leptun/AVRinator/Hardware/AVRinator.kicad_pcb

## KiCad design Hardware/AVRinator.kicad_pcb (2024-05-07)

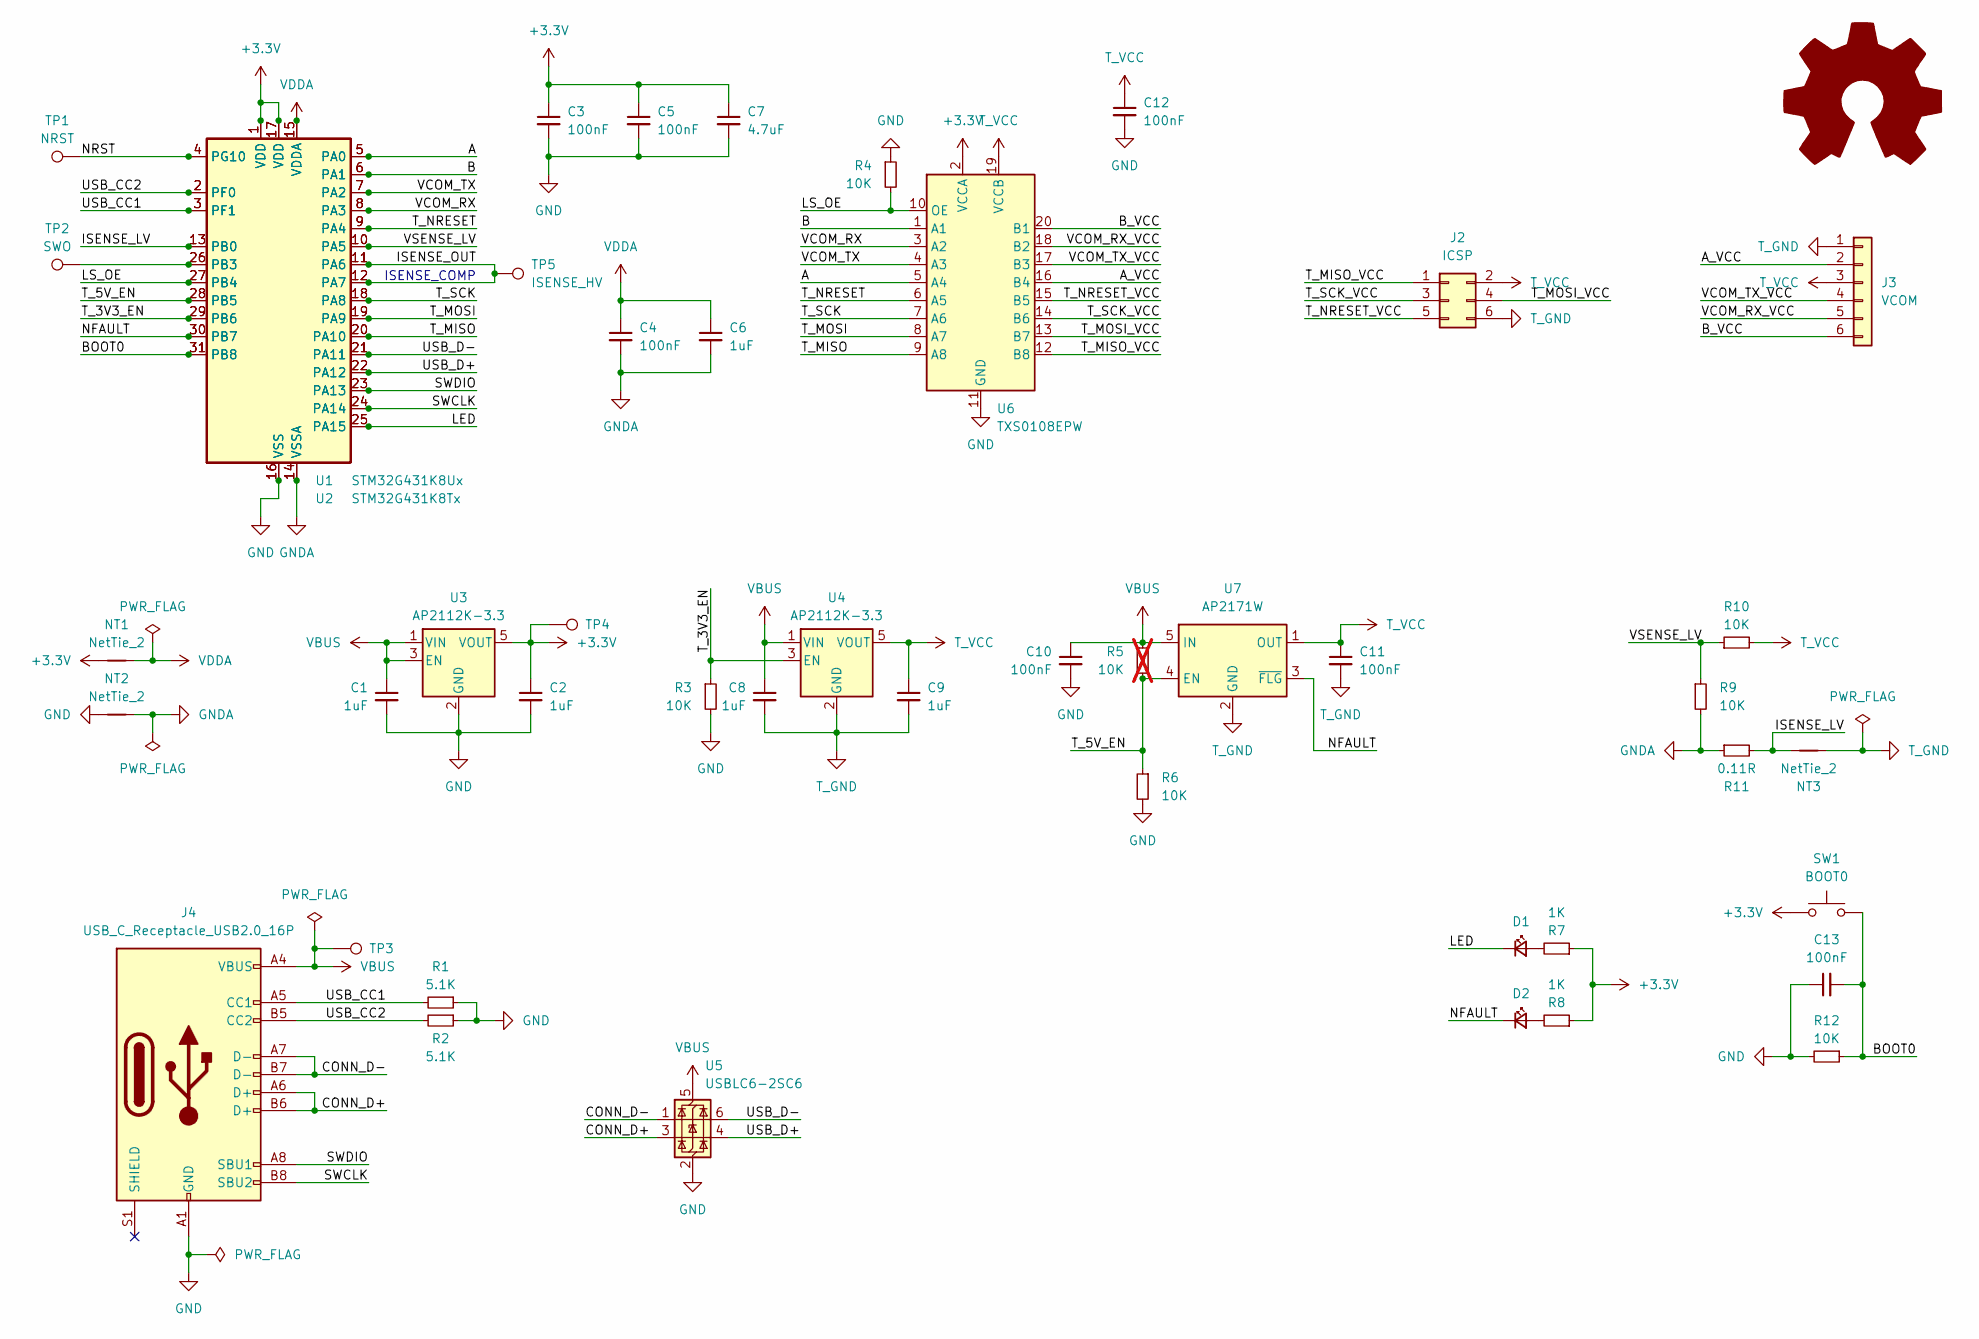
[picture p1: schematic AVRinator.kicad_sch]

Parts:
C1, C2, C6, C8, C9: 1uF; C_0805_2012Metric
C3, C4, C5, C10, C11, C12, C13: 100nF; C_0603_1608Metric
C7: 4.7uF; C_1206_3216Metric
D1, D2: LED_1206_3216Metric
J2: ICSP; 61200621621
J3: VCOM; PinSocket_1x06_P2.54mm_Horizontal
J4: USB_C_Receptacle_USB2.0_16P; USB4110-GF-A
NT1, NT2, NT3: NetTie_2; NetTie-2_SMD_Pad0.5mm
R1, R2: 5.1K; R_0603_1608Metric
R3, R4, R6, R9, R10, R12: 10K; R_0603_1608Metric
R5: 10K; R_0603_1608Metric; not fitted
R7, R8: 1K; R_0805_2012Metric
R11: 0.11R; R_0805_2012Metric
SW1: BOOT0; SW_Tactile_SPST_NO_Straight_CK_PTS636Sx25SMTRLFS
SYM1: AMOGUS; AMOGUS_lil
TP1: NRST; TestPoint_Pad_D1.0mm
TP2: SWO; TestPoint_Pad_D1.0mm
TP3: VBUS; TestPoint_Pad_D1.0mm
TP4: 3V3; TestPoint_Pad_D1.0mm
TP5: ISENSE_HV; TestPoint_Pad_D1.0mm
U1: STM32G431K8Ux; QFN-32-1EP_5x5mm_P0.5mm_EP3.45x3.45mm
U2: STM32G431K8Tx; LQFP-32_7x7mm_P0.8mm
U3, U4: AP2112K-3.3; SOT-23-5
U5: USBLC6-2SC6; SOT-23-6
U6: TXS0108EPW; TSSOP-20_4.4x6.5mm_P0.65mm
U7: AP2171W; SOT-23-5

Connections:
+3.3V: C2.1, C3.1, C5.1, C7.1, NT1.1, R7.1, R8.1, SW1.1, TP4.1, U1.1 (VDD), U1.17 (VDD), U2.1 (VDD), U2.17 (VDD), U3.5 (VOUT), U6.2 (VCCA)
/A: U1.5 (PA0), U2.5 (PA0), U6.5 (A4)
/A_VCC: J3.2, U6.16 (B4)
/B: U1.6 (PA1), U2.6 (PA1), U6.1 (A1)
/BOOT0: C13.2, R12.1, SW1.2, U1.31 (PB8), U2.31 (PB8)
/B_VCC: J3.6, U6.20 (B1)
/CONN_D+: J4.A6 (D+), J4.B6 (D+), U5.3 (I/O2)
/CONN_D-: J4.A7 (D-), J4.B7 (D-), U5.1 (I/O1)
/ISENSE_LV: NT3.1, R11.2, U1.13 (PB0), U2.13 (PB0)
/ISENSE_OUT: TP5.1, U1.11 (PA6), U1.12 (PA7), U2.11 (PA6), U2.12 (PA7)
/LED: D1.1 (K), U1.25 (PA15), U2.25 (PA15)
/LS_OE: R4.2, U1.27 (PB4), U2.27 (PB4), U6.10 (OE)
/NFAULT: D2.1 (K), U1.30 (PB7), U2.30 (PB7), U7.3 (~FLG)
/NRST: TP1.1, U1.4 (PG10), U2.4 (PG10)
/SWCLK: J4.B8 (SBU2), U1.24 (PA14), U2.24 (PA14)
/SWDIO: J4.A8 (SBU1), U1.23 (PA13), U2.23 (PA13)
/T_3V3_EN: R3.1, U1.29 (PB6), U2.29 (PB6), U4.3 (EN)
/T_5V_EN: R5.1, R6.1, U1.28 (PB5), U2.28 (PB5), U7.4 (EN)
/T_MISO: U1.20 (PA10), U2.20 (PA10), U6.9 (A8)
/T_MISO_VCC: J2.1, U6.12 (B8)
/T_MOSI: U1.19 (PA9), U2.19 (PA9), U6.8 (A7)
/T_MOSI_VCC: J2.4, U6.13 (B7)
/T_NRESET: U1.9 (PA4), U2.9 (PA4), U6.6 (A5)
/T_NRESET_VCC: J2.5, U6.15 (B5)
/T_SCK: U1.18 (PA8), U2.18 (PA8), U6.7 (A6)
/T_SCK_VCC: J2.3, U6.14 (B6)
/USB_CC1: J4.A5 (CC1), R1.2, U1.3 (PF1), U2.3 (PF1)
/USB_CC2: J4.B5 (CC2), R2.2, U1.2 (PF0), U2.2 (PF0)
/USB_D+: U1.22 (PA12), U2.22 (PA12), U5.4 (I/O2)
/USB_D-: U1.21 (PA11), U2.21 (PA11), U5.6 (I/O1)
/VCOM_RX: U1.8 (PA3), U2.8 (PA3), U6.3 (A2)
/VCOM_RX_VCC: J3.5, U6.18 (B2)
/VCOM_TX: U1.7 (PA2), U2.7 (PA2), U6.4 (A3)
/VCOM_TX_VCC: J3.4, U6.17 (B3)
/VSENSE_LV: R9.1, R10.1, U1.10 (PA5), U2.10 (PA5)
GND: C1.2, C2.2, C3.2, C5.2, C7.2, C10.2, C12.2, C13.1, J4.A1 (GND), J4.A12 (GND), J4.B1 (GND), J4.B12 (GND), NT2.1, R1.1, R2.1, R3.2, R4.1, R6.2, R12.2, U1.16 (VSS), U1.32 (VSS), U1.33 (VSS), U2.16 (VSS), U2.32 (VSS), U3.2 (GND), U5.2 (GND), U6.11 (GND)
GNDA: C4.2, C6.2, NT2.2, R9.2, R11.1, U1.14 (VSSA), U2.14 (VSSA)
unnamed: D1.2 (A), R7.2
unnamed: D2.2 (A), R8.2
unnamed: TP2.1, U1.26 (PB3), U2.26 (PB3)
T_GND: C8.2, C9.2, C11.2, J2.6, J3.1, NT3.2, U4.2 (GND), U7.2 (GND)
T_VCC: C9.1, C11.1, C12.1, J2.2, J3.3, R10.2, U4.5 (VOUT), U6.19 (VCCB), U7.1 (OUT)
VBUS: C1.1, C8.1, C10.1, J4.A4 (VBUS), J4.A9 (VBUS), J4.B4 (VBUS), J4.B9 (VBUS), R5.2, TP3.1, U3.1 (VIN), U3.3 (EN), U4.1 (VIN), U5.5 (VBUS), U7.5 (IN)
VDDA: C4.1, C6.1, NT1.2, U1.15 (VDDA), U2.15 (VDDA)

Notes on the sheet:
ISENSE_COMP

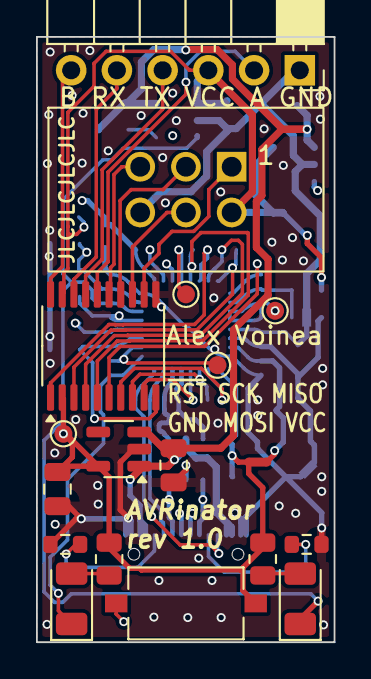
[picture p2: board AVRinator.kicad_pcb from above]

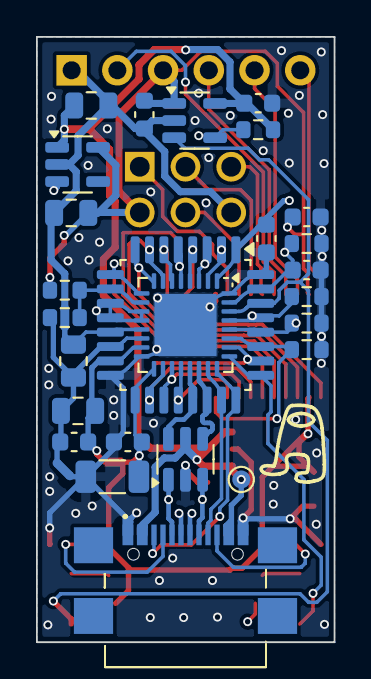
[picture p3: board AVRinator.kicad_pcb from below]

Board: 4 copper layers, 16.5 x 33.6 mm, 47 parts (29 on the bottom side), 44 nets.
