leptun/AVRinator/AVRinator_fw/AVRinator.ioc

Mcu.UserName=STM32G431K8Tx
PA0.GPIO_Label=A
PA0.Signal=SharedStack_PA0
PA1.GPIO_Label=B
PA1.Signal=SharedStack_PA1
PA10.GPIO_Label=T_MISO
PA10.Signal=USART1_RX
PA11.Signal=USB_DM
PA12.Signal=USB_DP
PA13.Signal=SYS_JTMS-SWDIO
PA14.Signal=SYS_JTCK-SWCLK
PA15.GPIO_Label=LED
PA15.Signal=GPIO_Output
PA2.GPIO_Label=VCOM_TX
PA2.Signal=USART2_TX
PA3.GPIO_Label=VCOM_RX
PA3.Signal=USART2_RX
PA4.GPIO_Label=T_NRESET
PA4.Signal=GPIO_Output
PA5.GPIO_Label=VSENSE_LV
PA5.Signal=SharedAnalog_PA5
PA6.GPIO_Label=ISENSE_OUT
PA6.Signal=SharedAnalog_PA6
PA7.GPIO_Label=ISENSE_COMP
PA7.Signal=SharedAnalog_PA7
PA8.GPIO_Label=T_SCK
PA8.Signal=USART1_CK
PA9.GPIO_Label=T_MOSI
PA9.Signal=USART1_TX
PB0.GPIO_Label=ISENSE_LV
PB0.Signal=SharedAnalog_PB0
PB3.Signal=SYS_JTDO-SWO
PB4.GPIO_Label=LS_OE
PB4.Signal=GPIO_Output
PB5.GPIO_Label=T_5V_EN
PB5.Signal=GPIO_Output
PB6.GPIO_Label=T_3V3_EN
PB6.Signal=GPIO_Output
PB7.GPIO_Label=NFAULT
PB7.Signal=GPIO_Input
PB8-BOOT0.GPIO_Label=SW
PB8-BOOT0.Signal=GPIO_Input
PF0-OSC_IN.GPIO_Label=USB_CC2
PF0-OSC_IN.Signal=SharedAnalog_PF0
PF1-OSC_OUT.GPIO_Label=USB_CC1
PF1-OSC_OUT.Signal=SharedAnalog_PF1
