leptun/AVRinator/(commit log)

2024-04-30 Add ISP header pinout
    [AVRinator.kicad_pcb]
2024-04-30 Generate gerber files
    [AVRinator-B_Cu.gbl, AVRinator-B_Mask.gbs, AVRinator-B_Paste.gbp, AVRinator-B_Silkscreen.gbo, AVRinator-Edge_Cuts.gm1, AVRinator-F_Cu.gtl, AVRinator-F_Mask.gts, AVRinator-F_Paste.gtp]
2024-05-01 Temporary vid pid workaround
    [config.hpp]
2024-05-01 PAVR restructure control callback stage handling
2024-05-02 fix eeprom initialization from empty
    [eeprom.cpp, eeprom.hpp]
2024-05-04 Fix CDC tx notification
    [ttl.cpp, usart.cpp]
2024-05-04 Add TXS0108EPW decoupling cap and tune skew of usb
    [AVRinator.kicad_pcb, AVRinator.kicad_sch]
2024-05-04 Final touchups
    [AVRinator.kicad_pcb]
2024-05-04 A bit more touchup
    [AVRinator.kicad_pcb]
2024-05-04 Update gerber files
    [AVRinator-B_Cu.gbl, AVRinator-B_Mask.gbs, AVRinator-B_Paste.gbp, AVRinator-B_Silkscreen.gbo, AVRinator-Edge_Cuts.gm1, AVRinator-F_Cu.gtl, AVRinator-F_Mask.gts, AVRinator-F_Paste.gtp]
2024-05-04 Add JLCJLCJLCJLC incantation
    [AVRinator-B_Cu.gbl, AVRinator-B_Mask.gbs, AVRinator-B_Paste.gbp, AVRinator-B_Silkscreen.gbo, AVRinator-Edge_Cuts.gm1, AVRinator-F_Cu.gtl, AVRinator-F_Mask.gts, AVRinator-F_Paste.gtp]
2024-05-04 CDC IN pumping instead of complete flush
2024-05-06 Isp groundwork
2024-05-07 Update pin naming
    [AVRinator.kicad_pcb, AVRinator.kicad_sch]
2024-05-07 Pin definitions
2024-05-07 NMI parity error handler
    [AVRinator.ioc, glue.cpp]
2024-05-08 Use PAVR2 vid pid
2024-05-08 Power management initial
2024-05-21 Functional ISP prototype
2024-05-23 Timing fixes, uart fixes, eliminate isp bus contention
    [AVRinator.ioc, AppMain.cpp, isp.cpp, main.h, pins.cpp, pins.hpp, power.cpp]
